aulisek/chytra_domacnost/dokumentace/aulich_chytra_domacnost_dokumentace.pdf

# GYMNASIUM JANA KEPLERA

### Parléˇrova 2/118, 169 00 Praha 6


# Zaˇrízení pro realizaci chytré domácnosti

# Maturitní práce

### Autor: Vladislav Aulich

### Tˇrída: 4.C

### Školní rok: 2020/2021

### Pˇredmˇet: Informatika

### Vedoucí práce: Emil Miler

### Praha, 2021

# GYMNASIUM JANA KEPLERA Kabinet informatiky

# ZADÁNÍ MATURITNÍ PRÁCE

Student: | Vladislav Aulich
Tˇrída: | 4.C
Školní rok: | 2020/2021
Platnost zadání: | 30. 9. 2021
Vedoucí práce: | Emil Miler
Název práce: | Zaˇrízení pro realizaci chytré domácnosti

## Pokyny pro vypracování: Cílem práce je vytvoˇrit chytrou domácnost, konkrétnˇe ovládání svˇetel pomocí mikrokontroleru. Systém bude možné ovládat pomocí jednoduchého rozhraní z poˇcítaˇce ˇci mobilního zaˇrízení. Systém bude libovolnˇe rozšiˇritelný o další ˇcidla

a senzory.

## URL repozitáˇre:

## https://github.com/aulisek/chytra_domacnost

vedoucí práce | student

## V Praze dne 30. 10. 2020

# Prohlášení

Prohlašuji, že jsem svou práci vypracoval samostatnˇe a použil jsem pouze prameny a literaturu uvedené v seznamu bibliografických záznam ˚u. Nemám žádné námitky proti zpˇrístupˇnování této práce v souladu se zákonem ˇc. 121/2000 Sb. o právu autorském, o právech souvisejících s právem autorským a o zmˇenˇe nˇekterých zákon ˚u (autorský zákon) ve znˇení pozdˇejších pˇredpis ˚u.

V Praze dne 27. bˇrezna 2021 | Vladislav Aulich

# Podˇekování

Touto cestou bych rád podˇekoval svému vedoucímu práce Emilu Milerovi za zap ˚ujˇcení hardwarového vybavení, podporu a odbornou pomoc pˇri tvorbˇe projektu. Dále bych chˇel podˇekovat svému bratrovi za pomoc pˇri stavbˇe 3D tiskárny a odstraˇnováním následných vad tisku a své sestˇre za pomoc pˇri testování a motivaci k dokonˇcení projektu.

# Abstrakt

Tento projekt se zabývá realizací chytré domácnosti. Pro tvorbu projektu byl zvolen mikrokontrolér Arduino uno a ˇcip ESP32. Komunikace mezi zaˇrízeními je realizovaná bezdrátovˇe za použití otevˇrené rádiové frekvence 433 MHz. V rámci projektu bylo vytvoˇreno jednoduché webové rozhraní v HTML. Souˇcástí projektu je i výroba hardware s použitím metody 3D tisku na tiskárnˇe Ender 3 pro. Vývoj kódu probíhal v prostˇredí Arduino IDE, pro trasování zmˇen byl využit verzovací systém git.

## Klíˇcová slova

Chytrá domácnost, automatizace, ESP32, Arduino, Arduino IDE, 433 MHz, HTML

# Abstract

This project deals with the implementation of a smart home. The project is created using an Arduino uno microcontroller and an ESP32. Communication between devices is realized wirelessly using an open radio frequency of 433 MHz. Within the project, a simple web interface in HTML was created. The project also includes the production of hardware using the 3D printing method on the Ender 3 pro printer. The code was developed in the Arduino IDE environment, and the git versioning system was used to trace the changes.

## Keywords

smart home, automation, ESP32, Arduino, Arduino IDE, 433 MHz, HTML

# Obsah

1 Teoretická ˇcást | 3
2 Implementace | 5
3 Technická dokumentace | 15
Závˇer | 17
Seznam použité literatury | 19
Seznam obrázk ˚u | 21
Seznam tabulek | 22

# 1. Teoretická ˇcást

V první ˇcásti maturitní práce by se mˇela objevit informace o tom, jaký problém ˇrešíte. Co si Váš projekt klade za cíl?

# 1.1 Úvod

Toto téma jsem si zvolil, protože jsem chtˇel blíže prozkoumat práci s platformou Arduino a ESP32. S programováním tˇechto zaˇrízení jsem mˇel minimální zkušenosti, proto pro mˇe byla práce na projektu výzvou k objevování nového. Použití komunikace na rádiové frekvenci jsem zvolil z d ˚uvodu široké škály použití a velkého množství pˇríklad ˚u. Zároveˇn jsem mˇel doma nevyužívaný ovladaˇc pracující s touto frekvencí.

Motivací k výbˇeru tématu „chytré domácnosti“ mi bylo její ˇcím dál vˇetší nasazování v domácnostech a snaha vytvoˇrit si ji po svém. Na mnohých komerˇcních ˇrešeních mi totiž nevyhovoval zp ˚usob ovládání, nutnost dokupovat r ˚uzné sety, stejnˇe jako velký zásah do soukromí uživatel ˚u.

# 1.2 Cíl práce

Cílem této práce je vytvoˇrit zaˇrízení pro realizaci chytré domácnosti. Zaˇrízení si klade za cíl ovládat spotˇrebiˇce uživatele tzv. „na dálku“. Souˇcástí ˇrešení musí být uživatelské rozhraní, možnost další automatizace a možnost ovládání „offline“.

Teoretická ˇcást

# 2. Implementace

Druhá kapitola obsahuje detailní informace o tom, jak probíhala implementace. Zde se objeví zd ˚uvodnˇení výbˇeru technologií, ˇrešení problém ˚u, na které jste narazili, informace o použitých knihovnách apod. Pochvalte se, nikdo to za Vás neudˇelá. Pˇriznejte chyby, není to ostuda.

# 2.1 Schéma ˇrešení

Pro dosažení cíle práce jsem projekt rozdˇelil na dvˇe nezávislá zaˇrízení:

- Centrály - brány ovládající další zaˇrízení
- Koncového zaˇrízení ovládajícího spotˇrebiˇc

Pro každé zaˇrízení jsem pak implementoval potˇrebné funkce. Dále bylo potˇreba zajistit jejich vzájemnou komunikaci.

## 2.1.1 Centrála

Pro „centrálu“ jsem si vybral platformu ESP32 (konkrétnˇe model NODE-MCU32-S¹
) a to hned z
nˇekolika d ˚uvod ˚u. Cip má integrovanou wifi, k dispozici je velké množství dokumentace, hardwaru ˇ s pˇríklady a knihovnami. Další výhodou je velká komunita, což m ˚uže pomoct pˇri ˇrešení problém ˚u. Cip lze také integrovat do prostˇredí Arduino IDE, což umožˇnuje snadnˇejší práci pˇri tvorbˇe kódu. ˇ

Pˇri výbˇeru jsem zvažoval i platformu raspberry pi, ale odradila mˇe pˇrítomnost operaˇcního systému, který je zbyteˇcný pro tak malý projekt a velké poˇrizovací náklady oproti ESP32.

Centrála zajišt’uje nˇekolik funkcí:

- Komunikace s uživatelem
- Komunikace mezi zaˇrízeními
- Správa uložených zaˇrízení

## Komunikace s uživatelem

Pro komunikaci s uživatelem je vytvoˇreno jednoduché webové rozhraní umožˇnující dynamicky vypsat uložená zaˇrízení a pˇridat nové. Pro tvorbu webového rozhraní jsem zvolil knihovnu ESPAsyncWebServer²
. Tato knihovna má dobˇre zpracovanou dokumentaci a pro nasazení v projektu se hodí svými funkcemi. Samotné pˇripojení ˇcipu k Wi-Fi je realizováno pomocí knihovny WiFi³

1https://rpishop.cz/iot/2605-waveshare-nodemcu-32s-esp32-wifi-bluetooth-vyvojova-deska.

html (https://rpishop.cz/iot/2605-waveshare-nodemcu-32s-esp32-wifi-bluetooth-vyvojova-deska.html)
2https://github.com/me-no-dev/ESPAsyncWebServer3https://github.com/arduino-libraries/WiFi

Implementace

První verze kódu mˇely implementovaný jednoduchý synchronní webserver pomocí knihovny WiFi, obsažené v základní verzi Arduina IDE. Toto ˇrešení nebylo vhodné, protože numožˇnovalo pˇripojení více uživatel ˚u k rozhraní naráz.

Další implementovanou funkcí byla autentifikace uživatele. Tato funkce je zajištˇená pˇri odesílání requstu pomocí knihovny ESPAsyncWebServer.

Pro zjednodušení pˇrístupu k uživatelskému rozhraní je na zaˇrízení spuštˇen mDNS server na adrese http://esp32.local. Tato funkce je realizována pomocí knihovny ESPmDNS 4

Uživatelské rozhraní je vytvoˇreno pomocí HTML. HTML soubor je uložen ve vnitˇrní flash pamˇeti ˇcipu ESP. K ovládání filesystému SPIF je užito knihovny SPIFFS⁵
. Tato knihovna obsahuje všechny potˇrebné funkce.

Pro pˇridání nového zaˇrízení má uživatel na výbˇer mezi pˇridáním koupeného komerˇcního zaˇrízení nebo pˇridáním zaˇrízení vyrobeného v rámci tohoto projektu. Postup pˇri zadávání nového zaˇrízení je nastínˇen we webovém rozhraní.

Komunikace programu a webového rozhraní je zajištˇena pomocí HTTP GET request ˚u, které program zpracuje a provede potˇrebné akce.

## Komunikace mezi zaˇrízeními

Komunikace mezi zaˇrízeními je realizovaná bezdrátovˇe po frekvenci 433 MHz. Tento druh jsem zvolil z d ˚uvodu rozšíˇrenosti a nízkých poˇrizovacích náklad ˚u modul ˚u⁶
. Další nespornou výhodou je dosah, který v optimálním prostˇredí m ˚uže být až 200 m.

Další ze zvažovaných ˇrešení byla realizace pomocí Wi-Fi nebo GSM modulu. V prvním pˇrípadˇe jsem jako nevýhodu vidˇel dosah (závislost na dostupnosti pˇripojení). Dále by nebylo tak snadné ovládat zaˇrízení pomocí ovladaˇce. V druhém pˇrípadˇe byla nevýhoda cena a potˇreba realizace pˇripojení pomocí telefoního operátora.

Ovládání modul ˚u jsem chtˇel realizovat pomocí jednoduché knihovny VirtualWire, ale zjistil jsem, že není funkˇcní na ˇcipech ESP. K ovládání jsem tak použil knihovnu RadioHead.

Pro ovládání „Koncového zaˇrízení“ je vyslána zpráva obsahující ID zaˇrízení a tag ON nebo OFF, „koncové zaˇrízení“ následnˇe odchytí ID a provede pˇríkaz. Tento systém je do budoucna rozšiˇritelný o další tagy pro zaˇrízení, které potˇrebují k ovlání více pˇríkaz ˚u než ON nebo OFF.

Tento navržený systém jsem implementoval, nicménˇe jsem narazil na problém s ovládáním pomocí komerˇcního ovladaˇce. K tomuto úˇcelu jsem zaˇclenil knihovnu RCswitch⁷
, která umožˇnuje zobrazit protokol, na jehož základˇe právˇe komerˇcní zaˇrízení komunikují. Poté dokáže vysílat tímto protokolem.

Ve svém ˇrešení jsem chtˇel použít knihovny obˇe a rozdˇelit tak ovládání na dvˇe ˇcásti, podle toho, jakým zp ˚usobem mají komunikovat. Pˇri realizaci tohoto jsem však narazil na problém, že není

4https://github.com/espressif/arduino-esp32/tree/master/libraries/ESPmDNS5https://github.com/espressif/arduino-esp32/tree/master/libraries/SPIFFS6https://www.laskardu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

Implementace

možné bezdrátový vysílaˇc ovládat dvˇema knihovnami souˇcasnˇe.

Nakonec jsem vybral knihovnu RCswitch z d ˚uvodu vˇetší spolehlivosti pˇri pˇrenosu vysílání a možného rozšíˇrení na ovládání komerˇcních zaˇrízení (nebo ovládání komerˇcními zaˇrízeními). Toto ˇrešení sebou nese nutnost dvou kód ˚u, pro zapnutí a vypnutí (pˇri použití již výše zmiˇnovaného ovladaˇce).

## Správa uložených zaˇrízení

Zaˇrízení se ukládají pˇrímo do flash pamˇeti ESP32 o velikosti 4 MB. Soubor je nazván „zarizeni.csv“. Zaˇrízení se ukládají ve formátu CSV (comma separate value). Pro ovládání filesystému byla zvolena výše zmínˇená knihovna SPIFFS. Pro „parsování“ csv souboru jsem využil již hotové ˇrešení za pomocí knihovny CSVparser⁸
. Knihovna je pˇeknˇe zadokumentovaná a obsahuje vše, co jsem pro ˇctení CSV potˇreboval.

Do sloupce „název“ se uloží název, který si zadá sám uživatel v uživatelském rozhraní. Do sloupce „kod_ovladac“ se v pˇrípadˇe zaˇrízení vyrobeného v rámci projektu uloží „x“, protože k ovládání staˇcí ID zaˇrízení, které je v tomto pˇrípadˇe ve sloupci „kod_zarizeni“.

Pˇri zadávání komerˇcního zaˇrízení záleží na zp ˚usobu ovládání daného zaˇrízení. Pˇri tvorbˇe jsem vycházel z mého ovladaˇce, který má zvlášt’ kód pro vypnutí a zapnutí. Jiná zaˇrízení mají odlišná schémata.

Pro implementaci takového typu zaˇrízení je za potˇrebí analyzovat, jaký zp ˚usob ovládání zaˇrízení používá. K tomu slouží example kód knihovny RCswitch. Pro funkˇcnost ovládání je také potˇreba prostudovat dokumentaci k této knihovnˇe a dopsat správný typ ovládání do místa v kódu (Toto místo je oznaˇceno pˇrímo v kódu).

## 2.1.2 Koncové zaˇrízení

Toto je hlavní ˇcástí mého projektu. Koncové zaˇrízení provádí následující funkce:

- pˇrijímá požadavek od centrály
- zapne/vypne spotˇrebiˇc
- reaguje na pohyb
- obsahuje senzor svˇetla
- reaguje na vstup uživatele z tlaˇcítka

Pro „koncová zaˇrízení“ jsem zvolil jako vývojovou platformu Arduino uno⁹
. Po odladˇení kódu a
hardwaru jsem vyrobil prototyp, který již využíval Arduino Pro mini¹⁰ s pšti voltovou logikou.

Pro realizaci zapínání a vypínání spotˇrebiˇc ˚u jsem zvolil ovládání pomocí relé. Pro snadnˇejší ovládání jsem vybral již hotový modul pro arduino¹¹, který pokud je na vstupu logická 1 vypnutý, pokud je pˇrítomna zem, tak je zapnutý (je tzv. negovaný).

8https://github.com/michalmonday/CSV-Parser-for-Arduino9https://www.laskarduino.cz/arduino-uno-r3--atmega328p--klon/10https://www.laskarduino.cz/arduino-pro-mini--atm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

Implementace

Reakce na pohyb je zajišt’ována PIR senzorem¹². Opˇet byl zakoupen modul, který bylo snazší implementovat. Aby nedocházelo k zapnutí svˇetla ve dne, byl k senzoru pˇridán fotorezistor, který reaguje na hladinu svˇetla v místnosti. Pˇri tvorbˇe kódu pro fotorezistor jsem narazil na problém s rozeznáváním svˇetla od tmy. Fototorezistor v mém zapojení totiž neukazoval konstantní hodnoty.

Pˇri prvním pokusu ovládání jsem nastavil pevnou hranici pro tmu, kde jsem porovnával napˇetí na analogovém vstupu s pevnˇe danou hodnotou. Toto ˇrešení se neukázalo jako vhodné ve chvíli. kdy fotorezistor ukazoval hodnoty blízké k hranici, docházelo tak k rychlému spínání a vypínání svˇetla. Ve finálním kódu jsem použil hystereze a k tomuto efektu nedochází. Nevýhoda tohoto ˇrešení je, že si uživatel musí nastavit hranici tmy v kódu. Toto by se dalo vyˇrešit náhradou rezistoru za trimmer, kterým by uživatel mˇenil hodnotu odporu a s tím i napˇetí na amalogovém vstupu.

Pˇri pátrání na internetu jsem objevil právˇe takový modul¹³, který umožˇnoval trimmerem mˇenit „citlivost na tmu“. Proto jsem ho zakoupil a ve výsledném ˇrešení je implementován. Samotný modul má dva výstupy. Jeden je analogový ukazující „hladinu tmy“ a druhý je digitální, který má bud’ logickou jedniˇcku na svˇetle, zem pˇri tmˇe. Toto zapojení se tak i hodí k negovanému relé, kde lze zapojit modul napˇrímo k ovládání relé bez nutnosti mikrokontroleru.

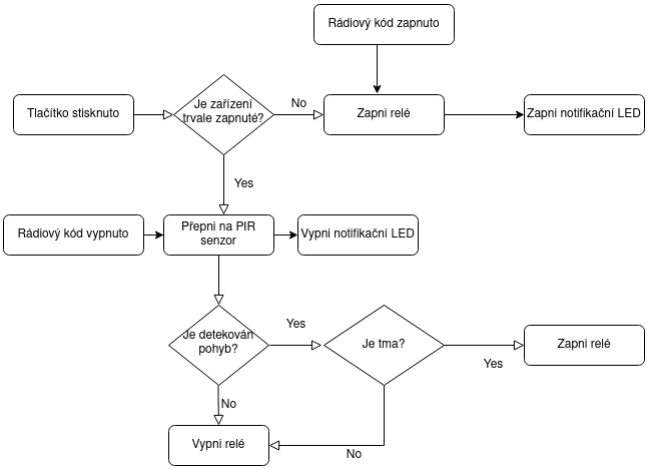
[picture p18: figure]

Obrázek 2.1: Schéma ˇcinností koncového zaˇrízení

12https://www.laskarduino.cz/arduino-pir-detektor-pohybu-hc-sr501/13https://www.laskarduino.cz/arduino-svetelny-senzor--4-pin-modul/

Implementace

# 2.2 Návrh prototypu

## 2.2.1 Centrála

Centrálu jsem se rozhodl ponechat v nepájivém kontaktním poli a vyrobit k ní krabiˇcku na 3D tiskárnˇe. Návrh krabiˇcky pro 3D tisk jsem tvoˇril v programu thinkercad.


Obrázek 2.2: Schéma zapojení centrály

## 2.2.2 Koncové zaˇrízení

## Pokus 1

Oddˇelení na snímání pohybu pomocí PIR ˇcidla a ovládání pomocí tlaˇcítka (ovladaˇce) jsem p ˚uvodnˇe chtˇel rozdˇelit hardwarovˇe. Jedna ˇcást by bylo Arduino, které pˇrijímá kód po rádiu a vstup uživatele z tlaˇcítka a druhá ˇcást by byl PIR senzor, který obstarává vše ostatní.

Protože PIR senzor má vlastní ˇcasovaˇc, logickou 1 dává na výstup vždy podle uživatele nadefinovanou dobu od posledního pohybu. Toho jsem chtˇel využít a spojit výstup arduina pomocí dvou diod s výstupem PIR senzoru a pˇripojit to na vstup relé. Toto ˇrešení však sebou neslo spoustu nevýhod.

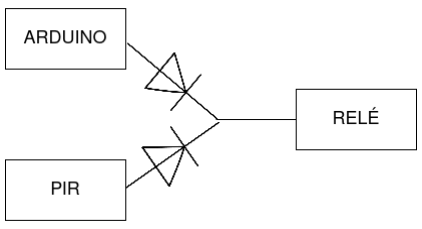
[picture p19: figure]

Obrázek 2.3: Schéma zapojení relé a diody

Toto ˇrešení nefungovalo perfektnˇe, kv ˚uli úbytku napˇetí na diodˇe (0.7 V), takže výstup s PIR nebyl iniciován jako logická 1. Další nevýhodou byl fakt, že používám negované relé. Tyto problémy by šly vyˇrešit použitím tranzistoru, nicménˇe i kv ˚uli detektoru hladiny svˇetla jsem toto ˇrešení zavrhl.

Implementace

## Pokus 2

Po prvním nezdaˇrilém pokusu jsem pˇrešel na kompletní ovládání arduinem. Nejprve jsem si všechny potˇrebné díly spojil v nepájivém kontaktním poli a potom jsem ovˇeˇril funkˇcnost kódu. Takto vyrobené zaˇrízení splˇnovalo všechny požadavky, takže jsem se rozhodl zaˇrízení pˇrenést do kompaktnˇejší podoby.

Opˇet jsem vytvoˇril návrh krabiˇcky pro 3D tisk. Pˇri návrhu krabiˇcky pro PIR senzor jsem vycházel již z hotového modelu¹⁴ staženého z portálu thinkverse, který jsem obohatil o díru na fotorezistor a notifikaˇcní LED. Návrh je od autora hills8, publikován je pod licencí creative commons-attribution. Návrh krabiˇcky pro zaˇrízení jsem již vytváˇrel sám. Moduly jsem následnˇe pˇrenesl na zakoupenou PCB návrhovou desku podle schématu.

# 2.3 Výroba prototypu

Tisk souˇcástek jsem provádˇel na tiskárnˇe Ender 3 pro, kterou jsem si sám složil. Pˇri pájení souˇcástek na desku jsem narážel na nedostateˇcné vybavení, ale myslím, že jsem nakonec udˇelal co bylo v mých silách.

## 2.3.1 3D tisk

Tisk probíhal na již zmínˇené tiskárnˇe Creality Ender 3 pro¹⁵. Tisknul jsem na originální magnetickou podložku, na tiskárnˇe byl vymˇeˇnen podavaˇc filamentu a pˇridán BLtouch zajišt’ující automatické „vyrovnání“ desky. Materiál pro tisk jsem zvolil PLA, konkrétnˇe jsem mˇel PLA od Creality¹⁶ v šedé barvˇe.

## Parametry tisku

- Podpˇery: NE
- Brim: NE
- Výška vrstvy: 0,2
- Výplˇn: 10% (mˇrížka)
- Filament: PLA
- Teplota podložka, první vrstva: 60°C
- Teplota podložka, ostatní vrstvy: 50°C
- Teplota tryska, první vrstva: 210°C
- Teplota tryska, ostatní vrstvy: 206°C


Implementace

Obrázek 2.4: Schéma zapojení koncového zaˇrízení s fotorezistorem v nepájivém kontaktním poli

Obrázek 2.5: Schéma zapojení koncového zaˇrízení se senzorem svˇetla v nepájivém kontaktním poli

Implementace

Poˇcet kus ˚u | Název | Cena [Kˇc]
1 | NodeMCU-32S ESP32 | 249
2 | 433 MHz vysílaˇc a pˇrijímaˇc | 79
2 | Spirálová anténa 433 MHz | 10
1 | Mikrospínaˇc | 4
2 | Relé modul s optickým oddˇelením | 65
1 | Rezistor 10k | 1
1 | Arduino Pro Mini | 98
1 | Arduino uno | 599
1 | PCB prototypová deska | 18
1 | PIR detektor pohybu | 38
1 | Detektor tmy | 20
1 | Konektor USB | 10
1 | USB napájecí kabel | 30

Tabulka 2.1: Kalkulace náklad ˚u

## 2.3.2 Kalkulace náklad ˚u

Celkové náklady na „centrálu“ bez 3D tisku jsou pˇribližnˇe 300 Kˇc. Celkové náklady za prototyp „koncového zaˇrízení“ bez 3D tisku je 265 Kˇc.

# 2.4 Možnosti automatizace

Díky ovládání pomocí HTTP GET request ˚u jsou možnosti automatizace pomocí softwaru tˇretích stran pomˇernˇe jednoduché. K automatizaci lze využít aplikaci Tasker¹⁷ pro Android, která nabízí velice rozsáhlé možnosti. Tato aplikace je placená, podobné funkce nabízí i aplikace Automate¹⁸ ,
která je zdarma.

Uživatel si v aplikaci m ˚uže nadefinovat chování „co se stane když“ v reakci na nˇejaký podmˇet. Lze si napˇríklad nadefinovat zapnutí svˇetla pokud se pˇripojíme k domácí wi-fi, nacházíme-li se na nˇejakých GPS souˇradnicích, v reakci na ˇcase, pˇri pˇríjmu oznámení telefonu a mnohem více. To, co tvoˇrí chytrou domácnost opravdu chytrou je právˇe automatizace. Na tu se projekt nezamˇeˇroval, nicménˇe implementace do projekt ˚u tˇretích stran není problém.

Struktura requestu pro zaˇrízení:

http://<IP_adresa_esp>/get?kod=<KOD>

14https://www.thingiverse.com/thing:2845890
15https://www.creality3dshop.eu/collections/ender-series-3d-printer/products/

creality3d-ender-3-pro-high-precision-3d-printer (https://www.creality3dshop.eu/collections/ender-series-3d-printer/products/creality3d-ender-3-pro-high-precision-3d-printer) 16https://www.creality3dshop.eu/collections/filament/products/3d-printer-silver-color-pla-filament-1-75mm-accuracy-0-05-mm-1kg17https://play.google.com/store/apps/deta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

US (https://play.google.com/store/apps/details?id=net.dinglisch.android.taskerm&hl=en_US&gl=US)
18https://play.google.com/store/apps/details?id=com.llamalab.automate&hl=en_US&gl=US

Implementace

Nebo pˇri použití mDNS

http://<esp32.local>/get?kod=<KOD>

Za kód dosadíme bud’ kód pro vypnutí nebo zapnutí zaˇrízení.

# 2.5 Návrhy na vylepšení

## 2.5.1 Uživatelské rozhraní

Pˇri zpracování rešerše na zaˇcátku projektu jsem objevil zajímavé ˇrešení uživatelského rozhraní pomocí Blynk¹⁹. Tato platforma má rozsáhlé možnosti, zejména pro „Internet vˇecí“. To by mé ˇrešení mohlo rozšíˇrit mimo domácí sít’ za využití cloudu. Samotný cloud je možné nainstalovat na vlastní zaˇrízení (napˇríklad raspberry pi), m ˚užete tak mít dohled nad svými daty. Zároveˇn projekt nabízí vytvoˇrení mobilní aplikace pro Android, mohl bych tak ˇrešení povýšit o mnoho pater výše, co se týˇce uživatelské pˇrívˇetivosti. Projekt je open-source, mobilní aplikaci je pak možné využívat i komerˇcnˇe. Implementace do projektu by nebyla v ˚ubec složitá.

## 2.5.2 Zaˇrízení

Nevýhoda „koncového zaˇrízení“ je napájení, kdy potˇrebujeme externí zdroj. Toto ˇrešení jsem zvolil kv ˚uli své jednoduchosti, zároveˇn by zaˇrízení pro zapojení do sítˇe potˇrebovalo revizi podle Vyhlášky
ˇc. 50/1978 Sb. Ceského úˇradu bezpeˇcnosti práce a ˇ | Ceského báˇnského úˇradu o odborné zp ˚usobilosti ˇ
v elektrotechnice²⁰

Jinak by zaˇrízení bylo schopné obstarávat všechny funkce, vešlo by se do elektroinstalaˇcní krabice místo normálního vypínaˇce. K této minimalizaci se také nabízí optimalizace použitých souˇcástek (používat základní komponenty místo modul ˚u, napˇríkalad relé) a sestavení plošného spoje. Ten by byl spolehlivˇejší, menší a pro toto nasazení daleko vhhodnˇejší.

Dále bych chtˇel do projektu zaˇclenit ovládání naší vjezdové brány na zahradu, která pracuje s plovoucím kódem na frekvenci 433 MHz. Toto by znamelo možnost otevírat bránu pomocí telefonu místo ovladaˇce a další možnosti automatizace, napˇríklad automatické zavlažování.

Dále jsem našel zajímavý projekt zabývající se ovládání rolet²¹. Tento projekt by nebyl problém realizovat a k ovládání použít své vytvoˇrené schéma a rozhraní. Naše domácnost by se tak stale zase o trochu chytˇrejší.

19https://blynk.io/
20https://www.zakonyprolidi.cz/cs/1978-5021https://www.instructables.com/Arduino-Motorized-Roller-Blinds/

Implementace

# 3. Technická dokumentace

Poslední kapitola obsahuje informace o tom, jak projekt, který v rámci maturitní práce vznikl, nainstalovat, spustit a používat.

# 3.1 Ukázka sekce

## 3.1.1 A jedné podsekce

# 3.2 A další sekce

Technická dokumentace

# Závˇer

Závˇer obsahuje shrnutí práce a vyjadˇruje se k míˇre splnˇení jejího zadání. Dále by se zde mˇelo objevit sebehodnocení studenta a informace o tom, co nového se nauˇcil a jak vnímal svou práci na projektu.

V rámci projektu jsem vytvoˇril funkˇcní soustavu zaˇrízení umožˇnující realizaci chytré domácnosti. Toto zaˇrízení splˇnuje všechny body zadání. Se zaˇrízením jsem spokojený, splˇnuje všechny mé požadavky. Do budoucna se nabízí rozšíˇrení a vylepšení zaˇrízení.

Pˇri tvorbˇe projektu jsem si osvojil mnoho nových dovedností. Pˇri sofwarovém návrhu jsem se blíže seznámil s prostˇredím Arduino IDE, práci s knihovnami a dokumentací. Nauˇcil jsem se práci se senzory a zp ˚usoby jejich pˇripojení. Pˇri tvorbˇe webového prostˇredí nasazení HTML a kaskádových styl ˚u. K zaznamenávání verzí projektu jsem používal verzovací systém git, zmˇeny jsem nahrával na server github. Bylo to moje první setkání s verzovacími systémy, ze zaˇcátku jsem trochu tápal, jak ho pˇresnˇe použít. Pˇri tvorbˇe kódu jsem však ocenil pˇrehlednost a vracení se ke starším verzím. Systém jsem ovládal z pˇríkazové ˇrádky, nauˇcil jsem se tak spravovat sv ˚uj soborový systém a efektivní práci s ním.

Realizace hardwarové ˇcásti mi pˇrinesla zkušenost s letováním, nahráváním programu do Arduina pro mini pomocí programátoru mimo prostˇredí Arduino IDE. Také jsem se nauˇcil základy programu fritzing pˇri tvorbˇe schémat zapojení modul ˚u. Nauˇcil jsem se základy 3D modelování pomocí softwaru thinkercad, následné pˇrevedení pˇredlohy modelu do hotové podoby použitím metody 3D tisku. S tím se pojí i samotná údržba 3D tiskárny. Po jejím složení jsem se rozhl pro nˇekolik úprav. Seznámil jsem se s firmwarem Marlin, nauˇcil jsem se ho upravovat, zkompilovat a nahrát ho do tiskárny za použití USBisp programátoru. Dále jsem se dozvˇedˇel více o materiálech pro 3D tisk a potˇrebným nastavením parametr ˚u tisku.

Pˇri tvorbˇe dokumentace jsem se seznámil se zázecím sytémem LATEX, který pro mˇe byl nový

# Seznam použité literatury

[Ein05] Albert Einstein. “Zur Elektrodynamik bewegter Körper”. In: Annalen der Physik

322.10 (1905), s. 891–921. doi: http://dx.doi.org/10.1002/andp.19053221004. (https://doi.org/http://dx.doi.org/10.1002/andp.19053221004)
[Mal17] Martin Malý. Hradla, volty, jednoˇcipy: úvod do bastlení. Praha: CZ.NIC, 2017. isbn:

978-80-88168-23-2.
[Mil87] Boleslav Cernoch Milan Syrovátko. ˇ | Polovodiˇcová technika. Praha: SNTL - Naklada-
telství technické literatury, 1987.
[Old00] Pˇremysl Šedivý Oldˇrich Lepil. Fyzika pro gymnázia: elektˇrina a magmetismus. Praha:
Prometheus, 2000. isbn: 80-7196-202-3.
[San] | Nuno Santos. techtutorialsx. url: https://techtutorialsx.com/.
[Šra79] | Pavel Šrait. Od krystalky k model˚um s tranzistory. Praha: SNTL - Nakladatelství
technické literatury, 1979.

# Seznam obrázk ˚u

2.1 | Schéma ˇcinností koncového zaˇrízení | | 8
2.2 | Schéma zapojení centrály | | 9
2.3 | Schéma zapojení relé a diody | | 9
2.4 | Schéma zapojení koncového zaˇrízení s fotorezistorem v nepájivém kontaktním poli . . . | 11
2.5 | Schéma zapojení koncového zaˇrízení se senzorem svˇetla v nepájivém kontaktním poli . | 11

# Seznam tabulek
