aulisek/chytra_domacnost/3D_tisk_komponenty/centrala/vysilac_zakladna.stl

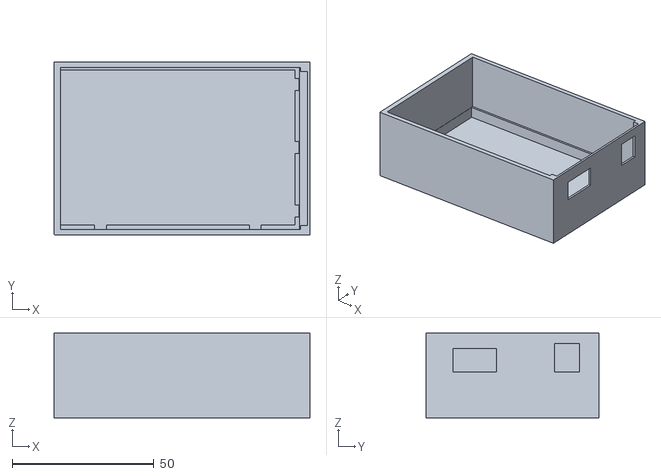
[picture p20: CAD file, 2021-03-30]
3D_tisk_komponenty/centrala/vysilac_zakladna.stl
90.4 x 61.0 x 30.0
