aulisek/chytra_domacnost/3D_tisk_komponenty/koncove_zarizeni/krabicka_vicko_limec.stl

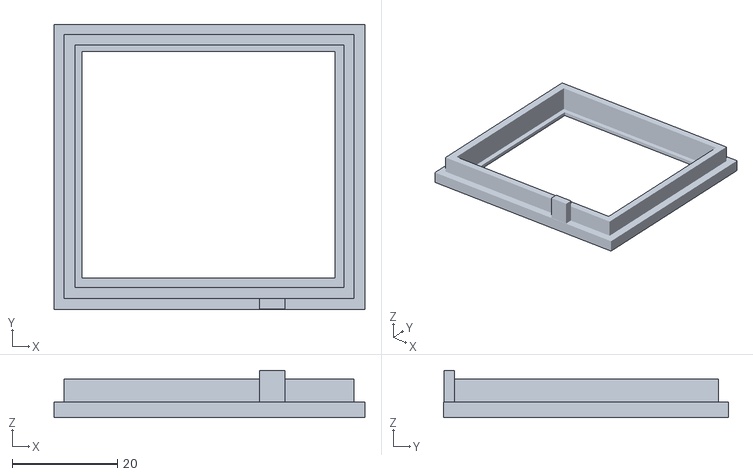
[picture p21: CAD file, 2021-04-08]
3D_tisk_komponenty/koncove_zarizeni/krabicka_vicko_limec.stl
59.0 x 54.0 x 9.00
