aulisek/chytra_domacnost/3D_tisk_komponenty/ovladac/drzak_na_ovladac.stl

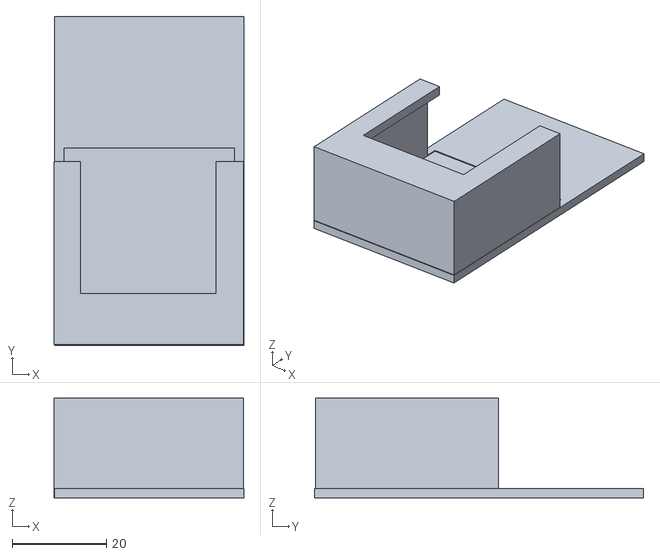
[picture p22: CAD file, 2021-03-12]
3D_tisk_komponenty/ovladac/drzak_na_ovladac.stl
40.4 x 70.0 x 21.2
