aulisek/chytra_domacnost/3D_tisk_komponenty/centrala/vysilac_vicko.stl

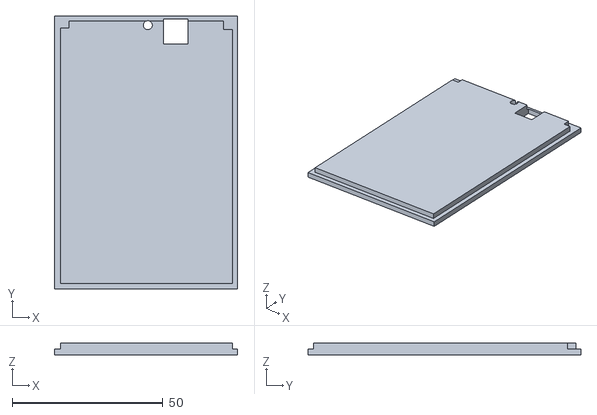
[picture p23: CAD file, 2021-03-30]
3D_tisk_komponenty/centrala/vysilac_vicko.stl
60.8 x 90.5 x 4.00
