aulisek/chytra_domacnost/3D_tisk_komponenty/koncove_zarizeni/krabicka_vicko.stl

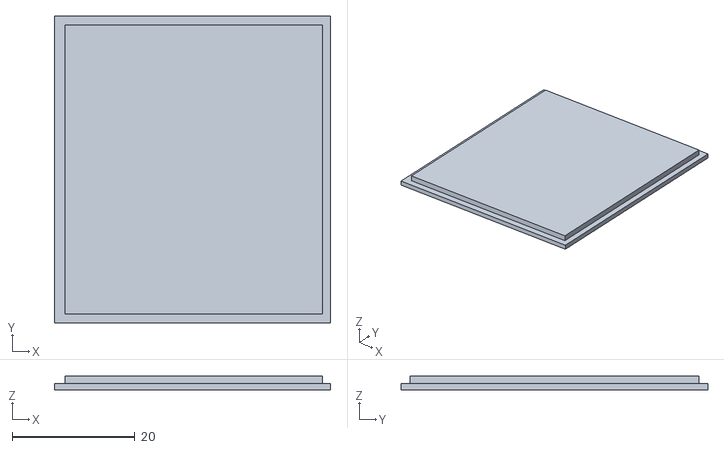
[picture p24: CAD file, 2021-04-08]
3D_tisk_komponenty/koncove_zarizeni/krabicka_vicko.stl
45.0 x 50.0 x 2.20
