aulisek/chytra_domacnost/3D_tisk_komponenty/centrala/vysilac_tlacitko.stl

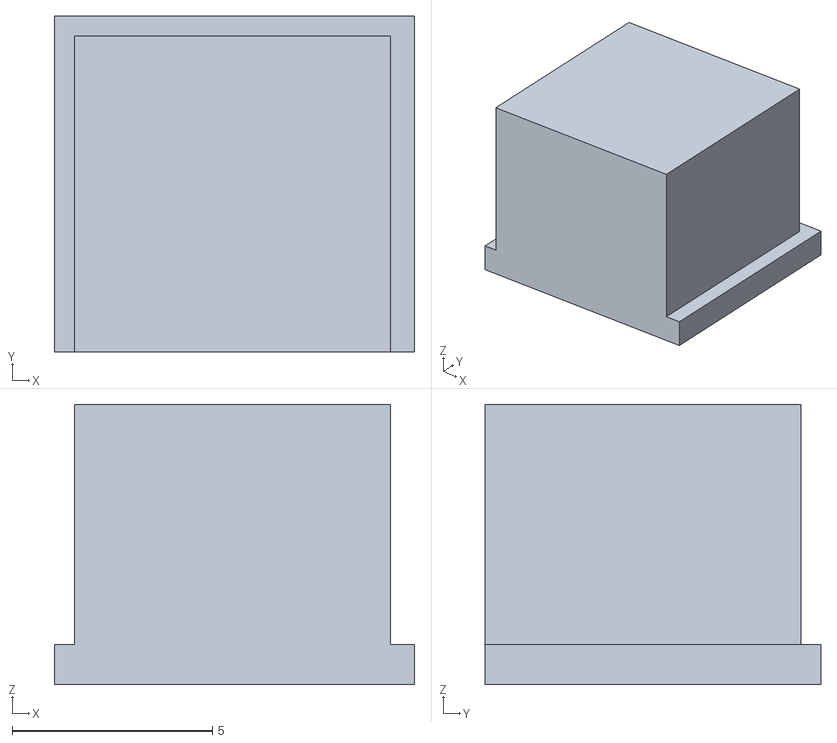
[picture p25: CAD file, 2021-03-30]
3D_tisk_komponenty/centrala/vysilac_tlacitko.stl
9.00 x 8.40 x 7.00
