aulisek/chytra_domacnost/3D_tisk_komponenty/koncove_zarizeni/krabicka_spodni_cast.stl

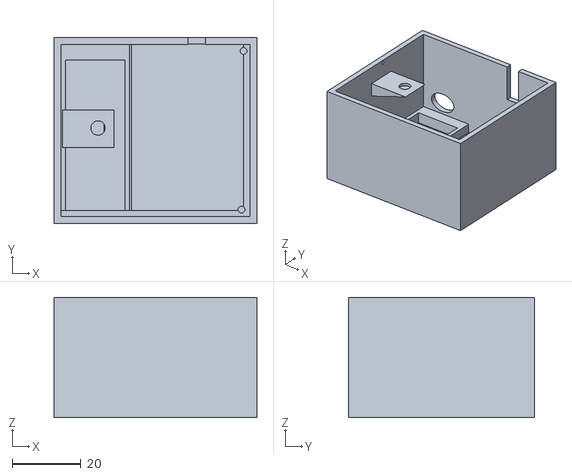
[picture p26: CAD file, 2021-04-08]
3D_tisk_komponenty/koncove_zarizeni/krabicka_spodni_cast.stl
59.0 x 54.0 x 35.0
