aulisek/chytra_domacnost/(list of files, drawings)

Other design files:
schemata_zdrojove_soubory/přijímač_zásuvka.fzz
schemata_zdrojove_soubory/přijímač_zásuvka_modul.fzz
schemata_zdrojove_soubory/vysilac.fzz
