aulisek/chytra_domacnost/(commit log)

2021-03-02 uprava fukcí pro práci se soubory
    [zarizeni.csv]
2021-03-04 oprava struktury
    [zarizeni.csv]
2021-03-05 přejmenování
    [zarizeni.csv]
2021-03-08 vylepseni requestu a provadecich uloh
    [zarizeni.csv]
2021-03-09 Přidán popis projektu
    [RF Transmitter mine.fz, RF Transmitter mine.fzz, project.cfg, přijímač_zásuvka.fzz, sketch.fz, sketch.fzz]
2021-03-12 přidán držák na arduino a breadbord
    [Arduino_UNO_breadboard-400.stl]
2021-03-12 přidán držák na ovladač
    [drzak_na_ovladac.stl]
2021-03-15 přidány 3D modely
    [spodni_cast.stl, vrchni_cast.stl, vysilac_krabicka.stl, vysilac_zakladna.stl]
2021-03-16 downgrade zpět k ovládání pomocí 2 kódů
    [zarizeni.csv]
2021-03-24 schémata_přidány zdrojové soubory
    [přijímač_zásuvka.fzz, přijímač_zásuvka_modul.fzz, vysilac.fzz]
2021-03-24 3D_modely_uprava adresare
    [Arduino_UNO_breadboard-400.stl, drzak_na_ovladac.stl, vysilac_krabicka.stl, vysilac_zakladna.stl]
2021-03-27 3D_model, přidána krabička na koncové zařízení
    [krabicka_spodni_cast.stl, spodni_cast.stl, vrchni_cast.stl, vysilac_zakladna.stl]
2021-03-27 uprava pinu pro LED
2021-03-30 3D tisk pridan model krabicky prijimace, uprava tlacitka
    [krabicka_spodni_cast.stl, krabicka_vicko.stl, krabicka_vicko_limec.stl, vysilac_tlacitko.stl, vysilac_vicko.stl, vysilac_zakladna.stl]
2021-04-08 fix rychlost serioveho monitoru
    [centrala.ino]
